artur-safonov/routine-controller-enclosure/cad/output/interior-rear.png

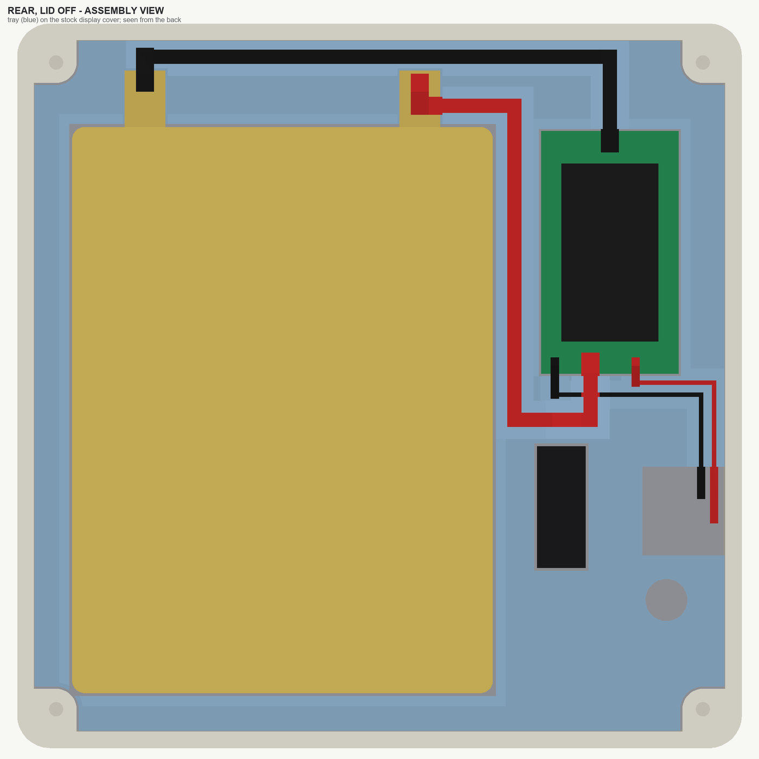
cad/output/interior-rear.png
