artur-safonov/routine-controller-enclosure/cad/output/sections.png

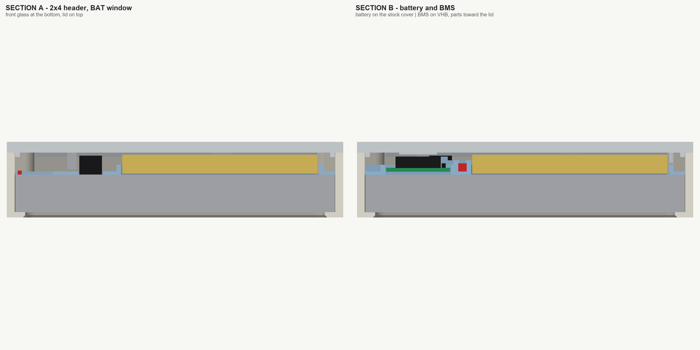
cad/output/sections.png
