artur-safonov/routine-controller-enclosure/cad/output/front-tub.stl

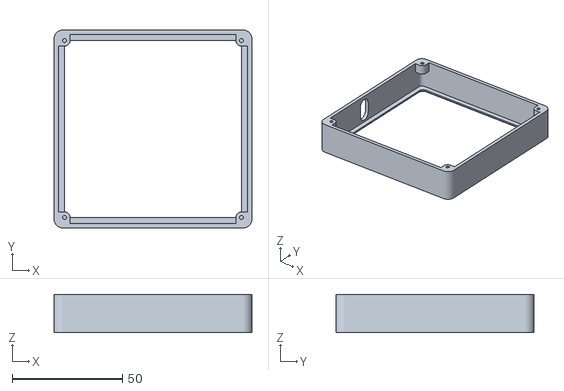
[picture p6: CAD file, 2026-10-19]
cad/output/front-tub.stl
89.6 x 89.6 x 17.3
