artur-safonov/routine-controller-enclosure/cad/output/rear-tray.stl

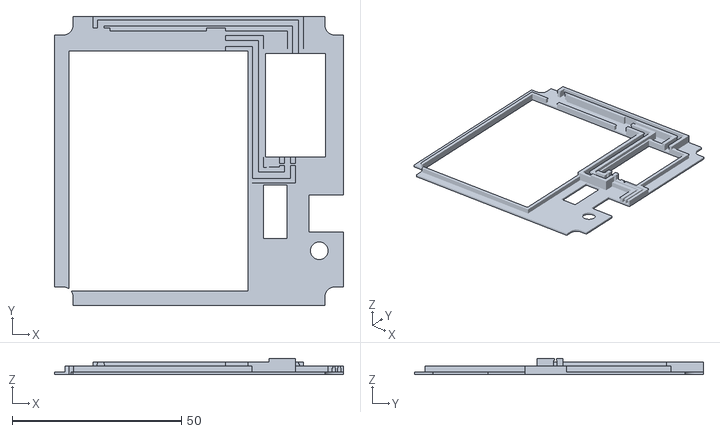
[picture p7: CAD file, 2026-10-19]
cad/output/rear-tray.stl
85.3 x 85.3 x 4.80
