artur-safonov/routine-controller-enclosure/cad/output/wall-dock.stl

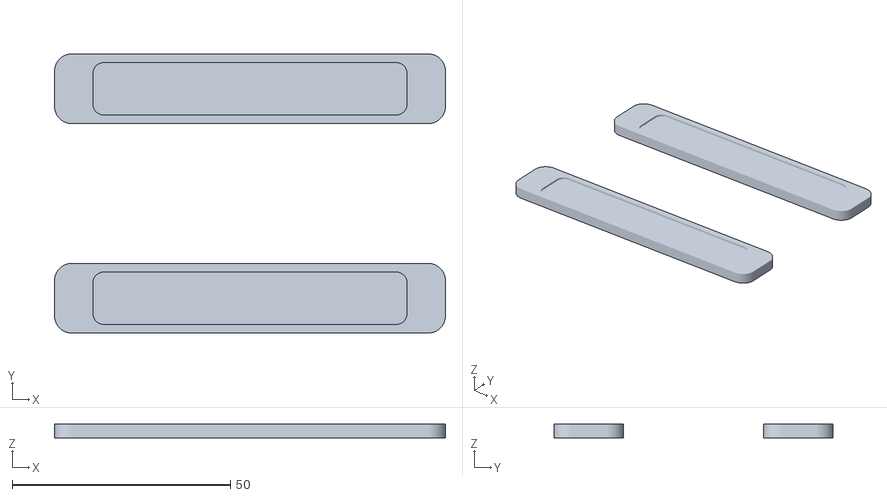
[picture p8: CAD file, 2026-10-19]
cad/output/wall-dock.stl
89.6 x 64.0 x 3.20
