artur-safonov/routine-controller-enclosure/cad/output/rear-lid.stl

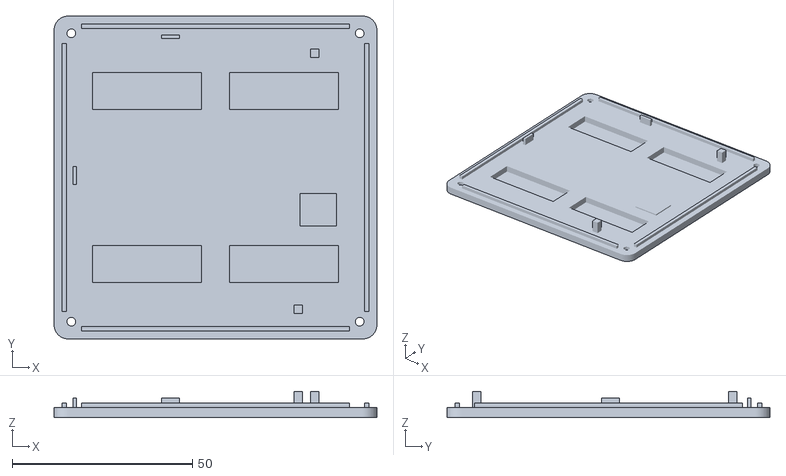
[picture p9: CAD file, 2026-10-19]
cad/output/rear-lid.stl
89.6 x 89.6 x 7.30
