artur-safonov/routine-controller-enclosure/cad/output/fit-coupon.stl

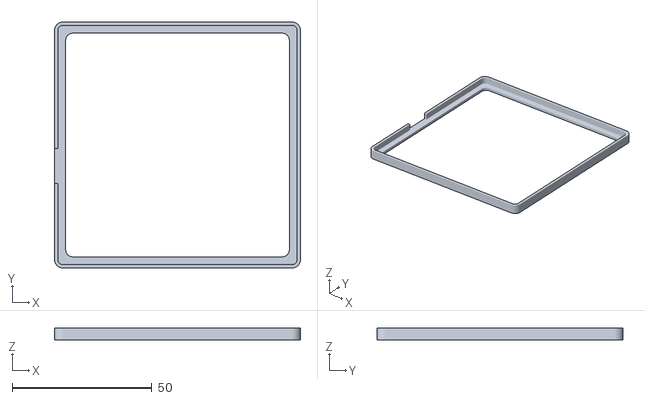
[picture p10: CAD file, 2026-10-19]
cad/output/fit-coupon.stl
88.0 x 88.0 x 4.40
